Ashwin-Rajesh/PLL_OSU180nm_VSD/docs/charge_pump_ckt.png

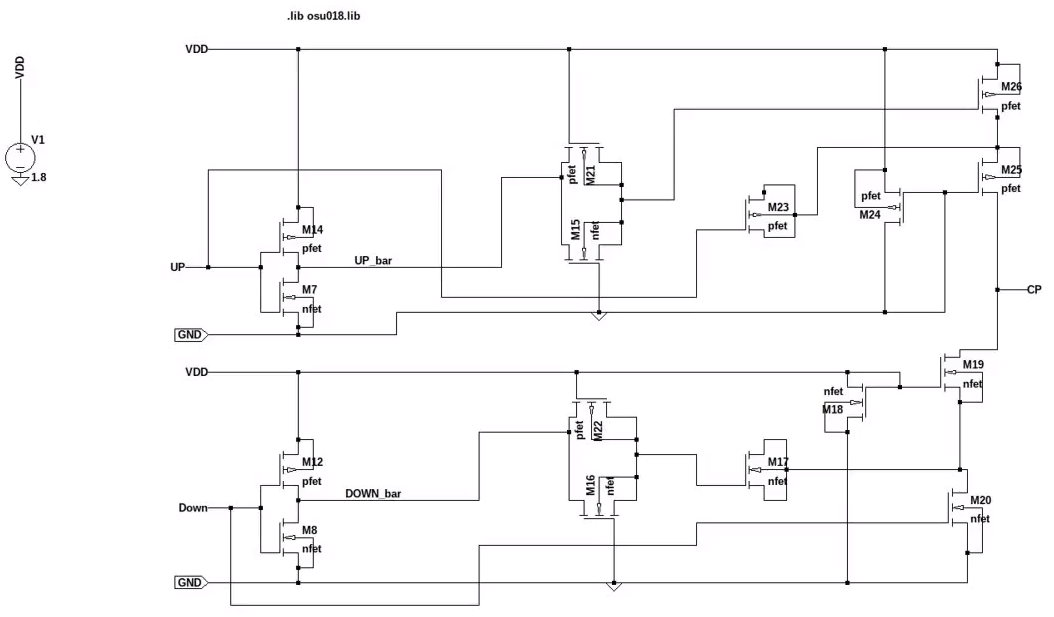
docs/charge_pump_ckt.png
