Ashwin-Rajesh/PLL_OSU180nm_VSD/docs/clk_div_ckt.png

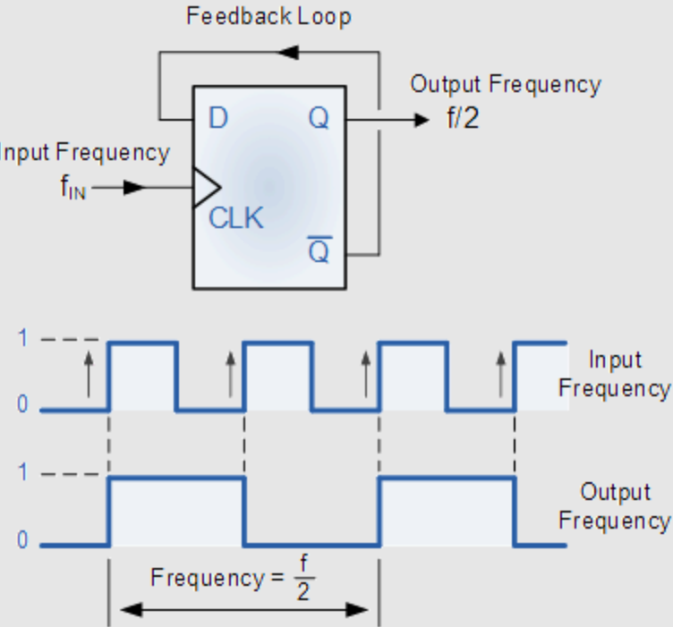
docs/clk_div_ckt.png
