Ashwin-Rajesh/PLL_OSU180nm_VSD/docs/lpf_ckt.png

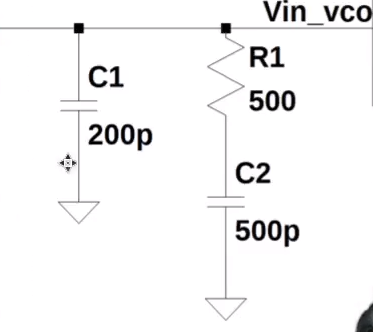
docs/lpf_ckt.png
