Ashwin-Rajesh/PLL_OSU180nm_VSD/docs/post_layout/freqdiv2_layout.png

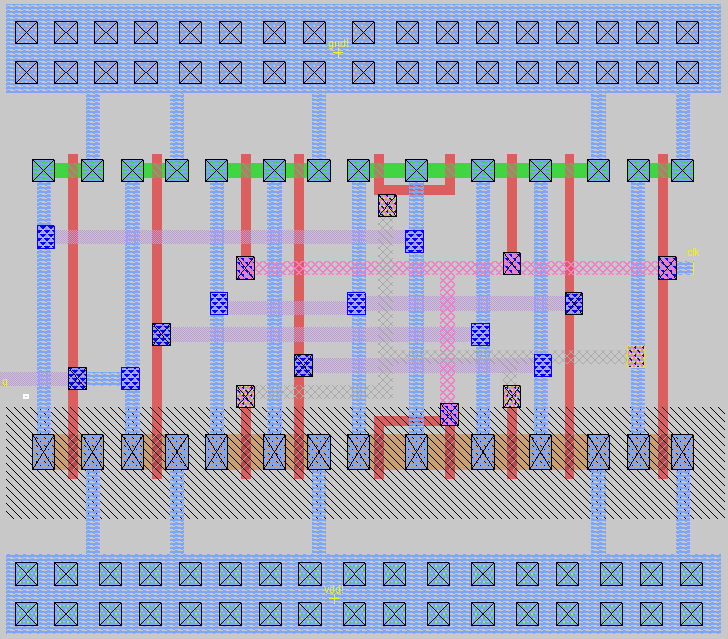
docs/post_layout/freqdiv2_layout.png
