Ashwin-Rajesh/PLL_OSU180nm_VSD/docs/post_layout/freqdiv8_out.png

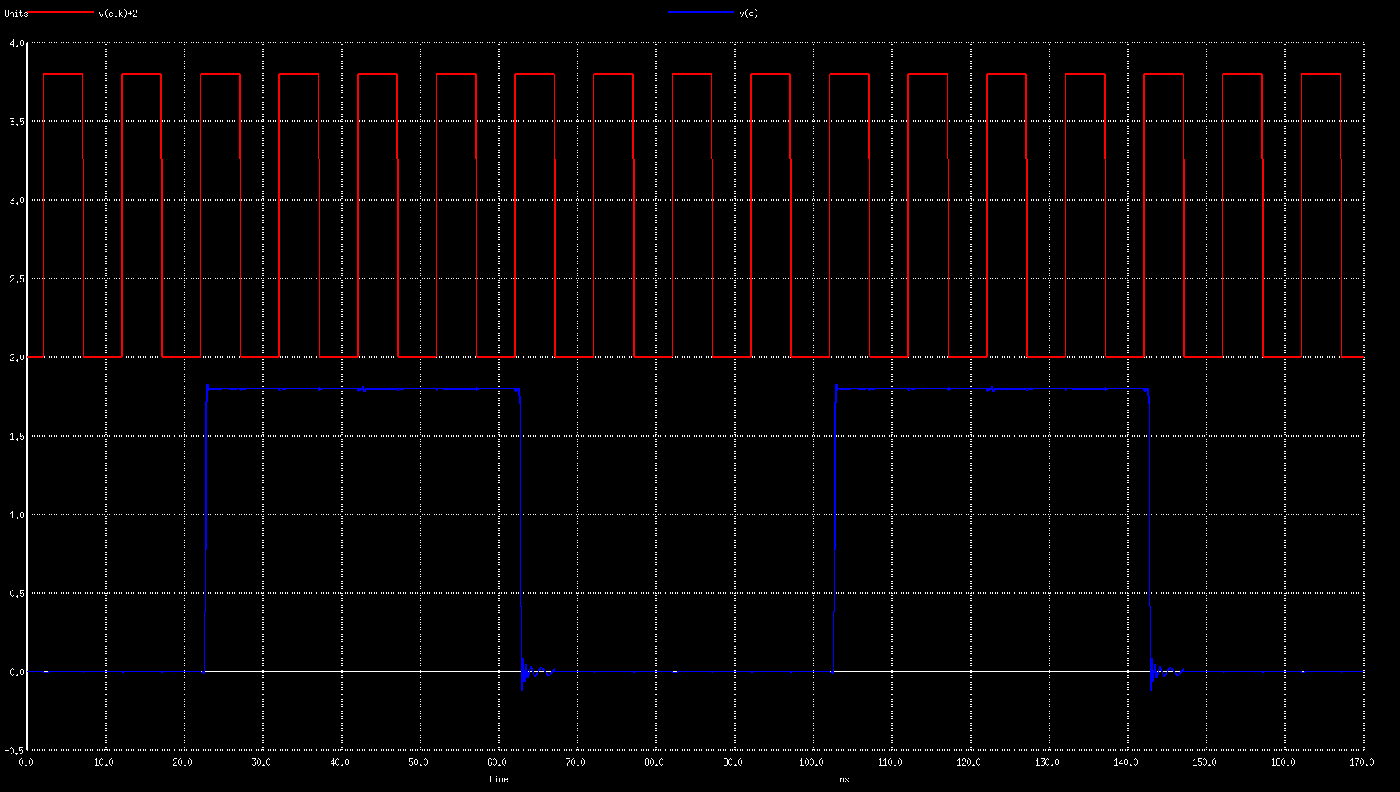
docs/post_layout/freqdiv8_out.png
