Ashwin-Rajesh/PLL_OSU180nm_VSD/docs/post_layout/pfd_layout.png

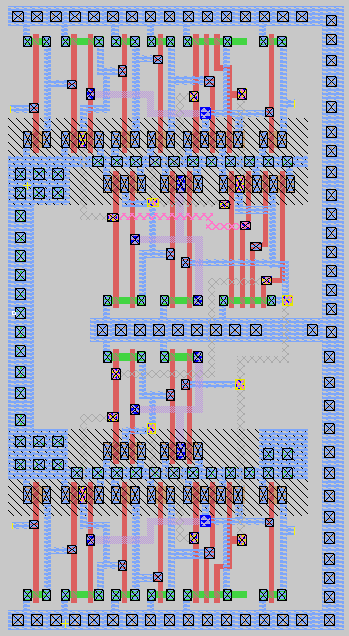
docs/post_layout/pfd_layout.png
