Ashwin-Rajesh/PLL_OSU180nm_VSD/docs/post_layout/pfd_out.png

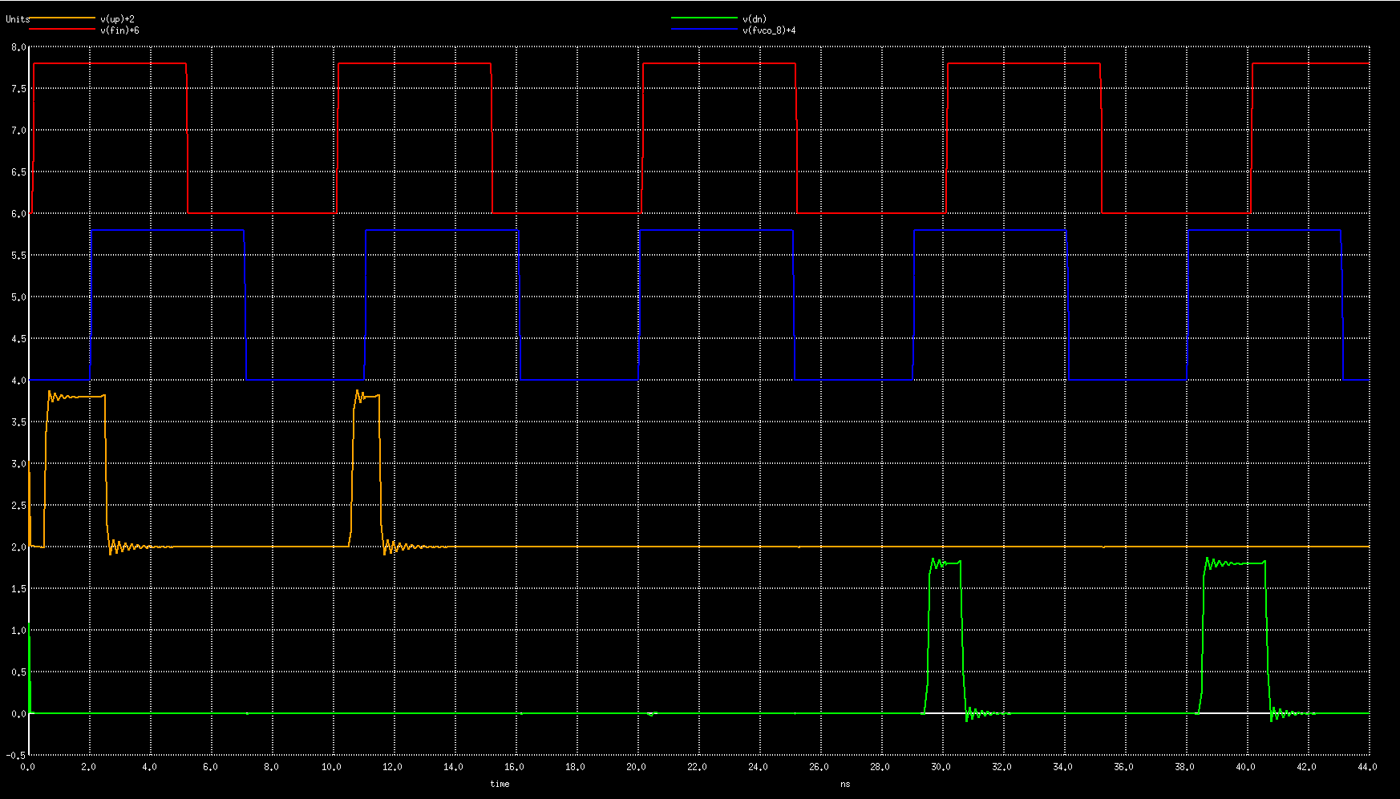
docs/post_layout/pfd_out.png
