Ashwin-Rajesh/PLL_OSU180nm_VSD/docs/post_layout/pll_out_err.png

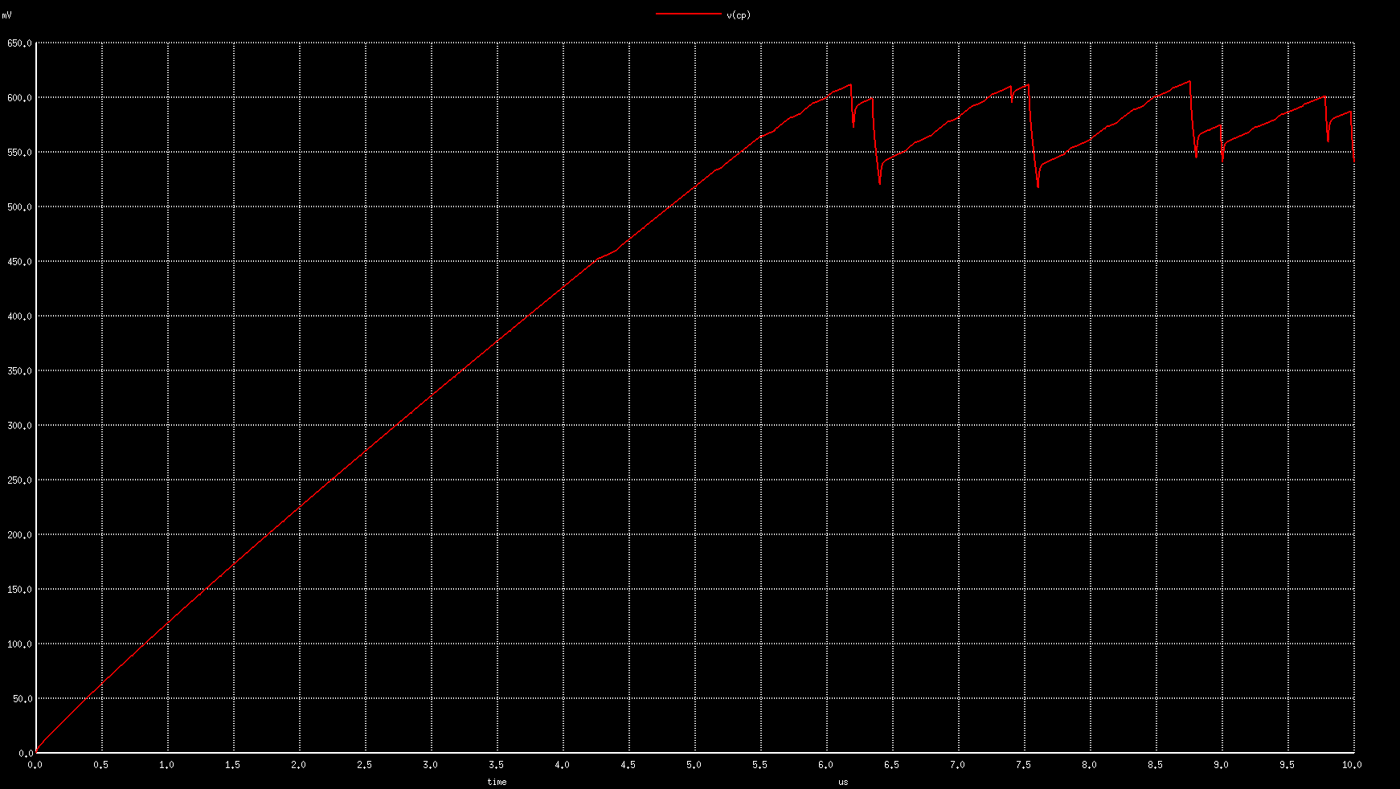
docs/post_layout/pll_out_err.png
