Ashwin-Rajesh/PLL_OSU180nm_VSD/docs/post_layout/vco_out_0.5.png

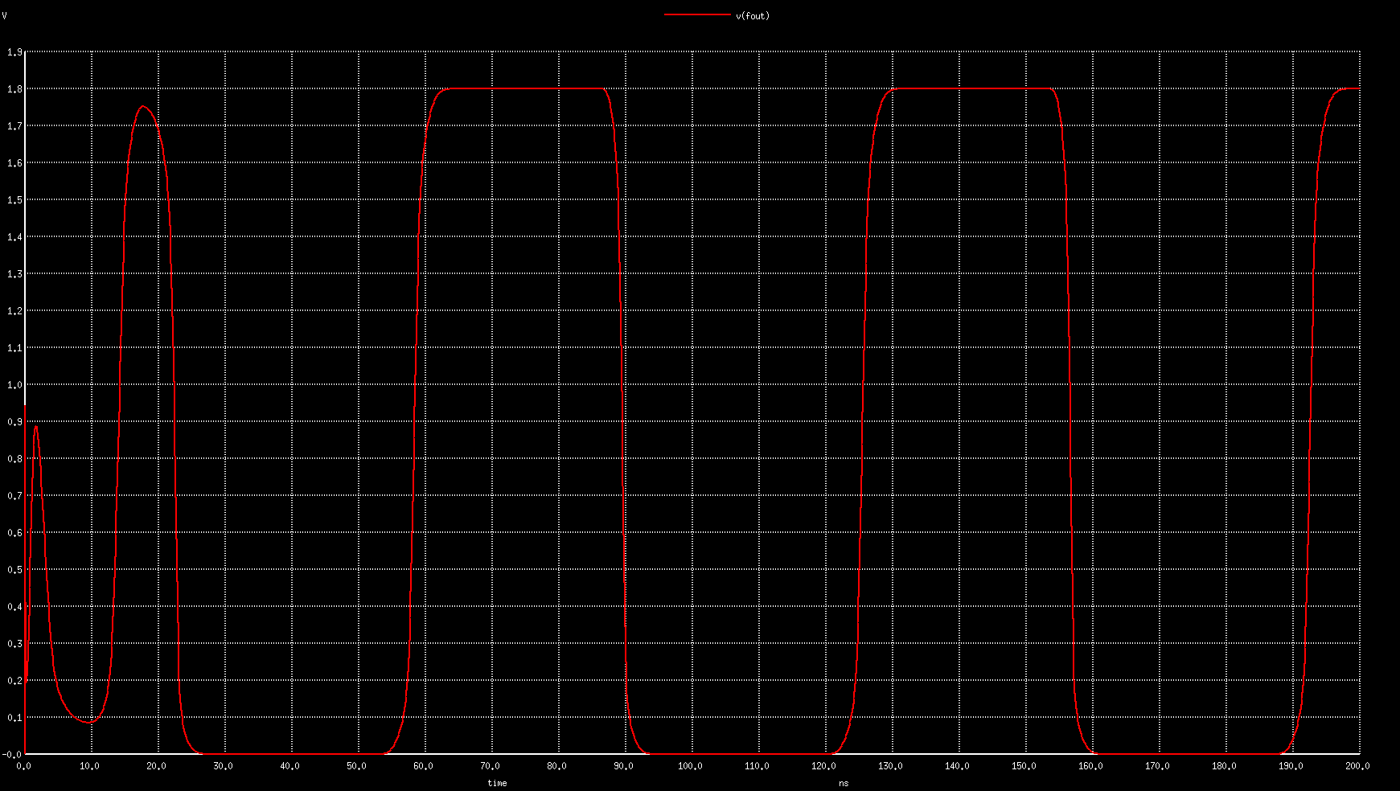
docs/post_layout/vco_out_0.5.png
