Ashwin-Rajesh/PLL_OSU180nm_VSD/docs/pre_layout/clk_div_out.png

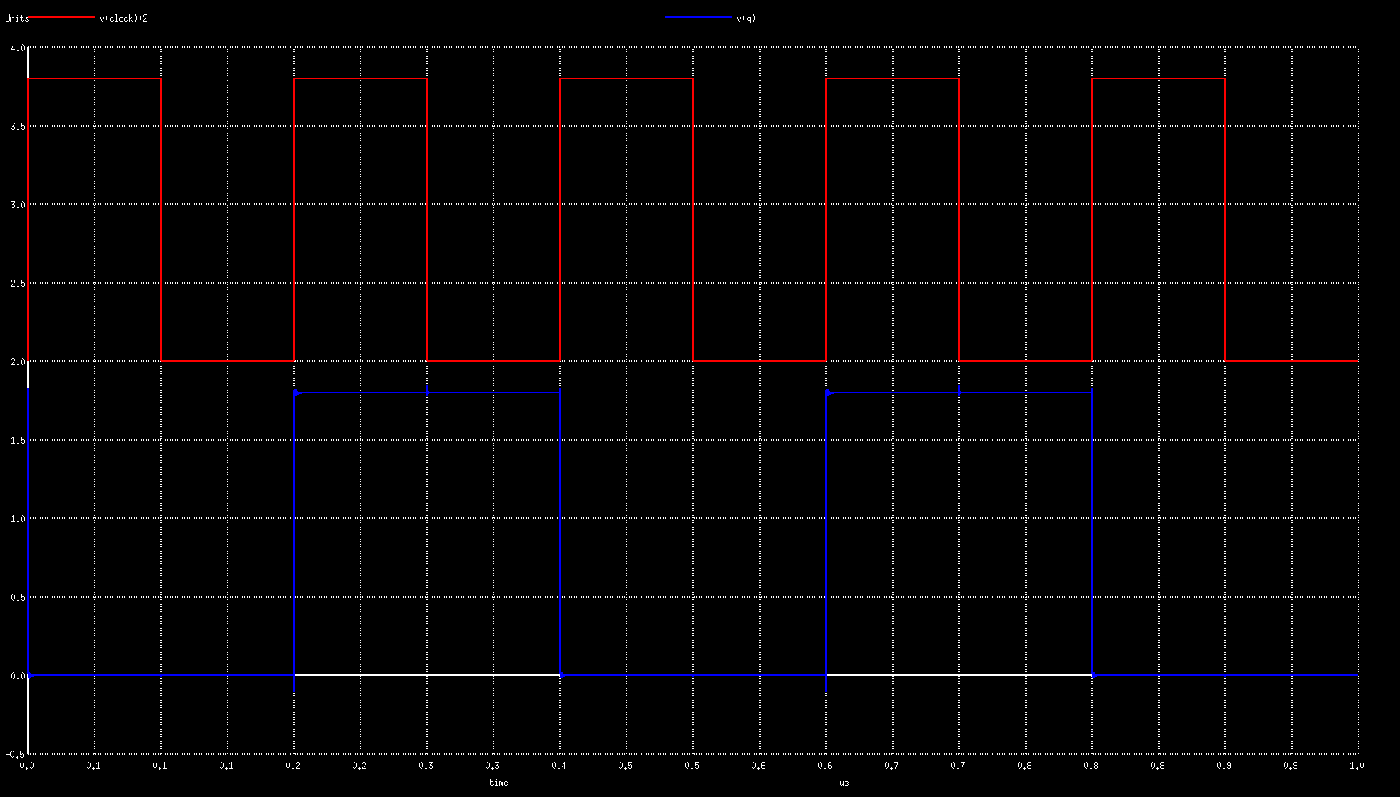
docs/pre_layout/clk_div_out.png
