Ashwin-Rajesh/PLL_OSU180nm_VSD/docs/pre_layout/pll_out.png

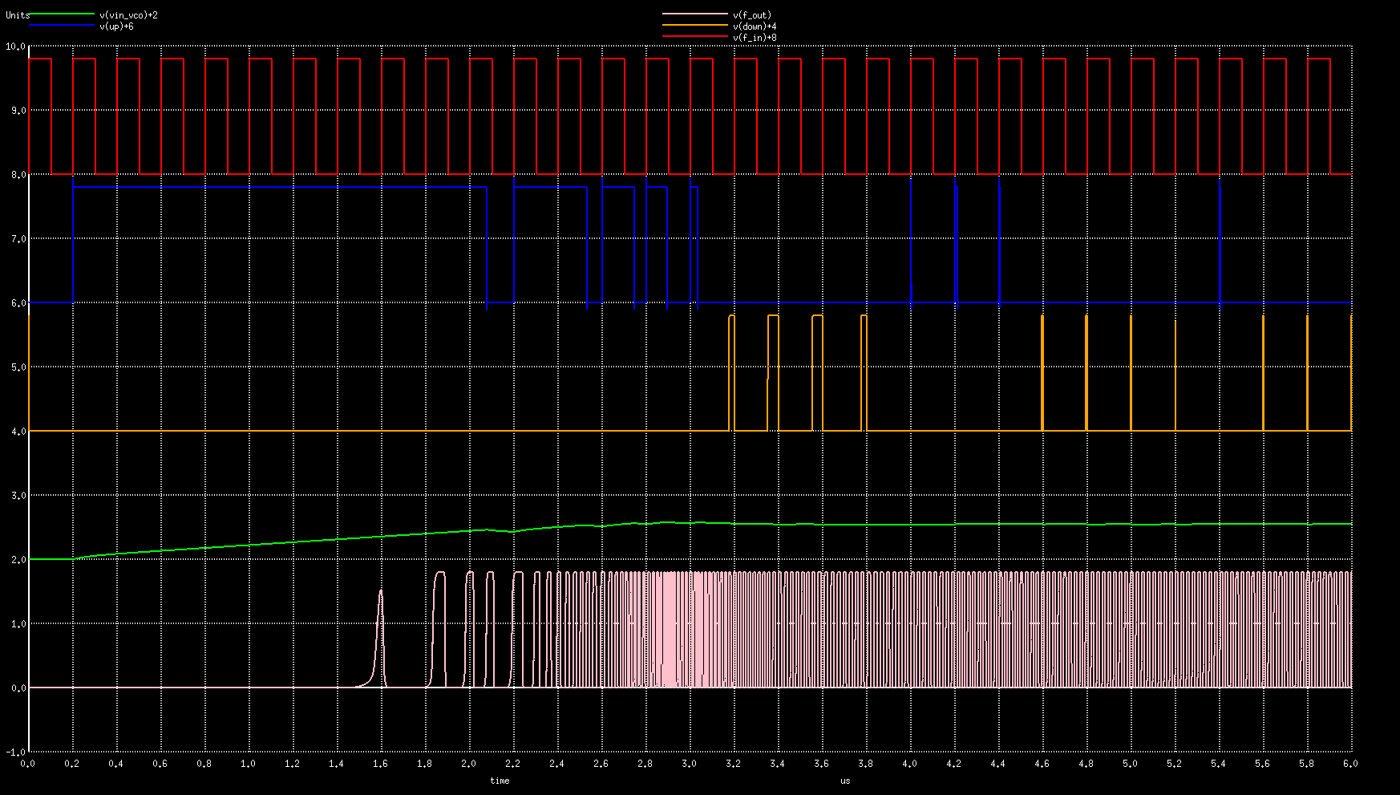
docs/pre_layout/pll_out.png
