Ashwin-Rajesh/PLL_OSU180nm_VSD/docs/pre_layout/vco_out_0.4.png

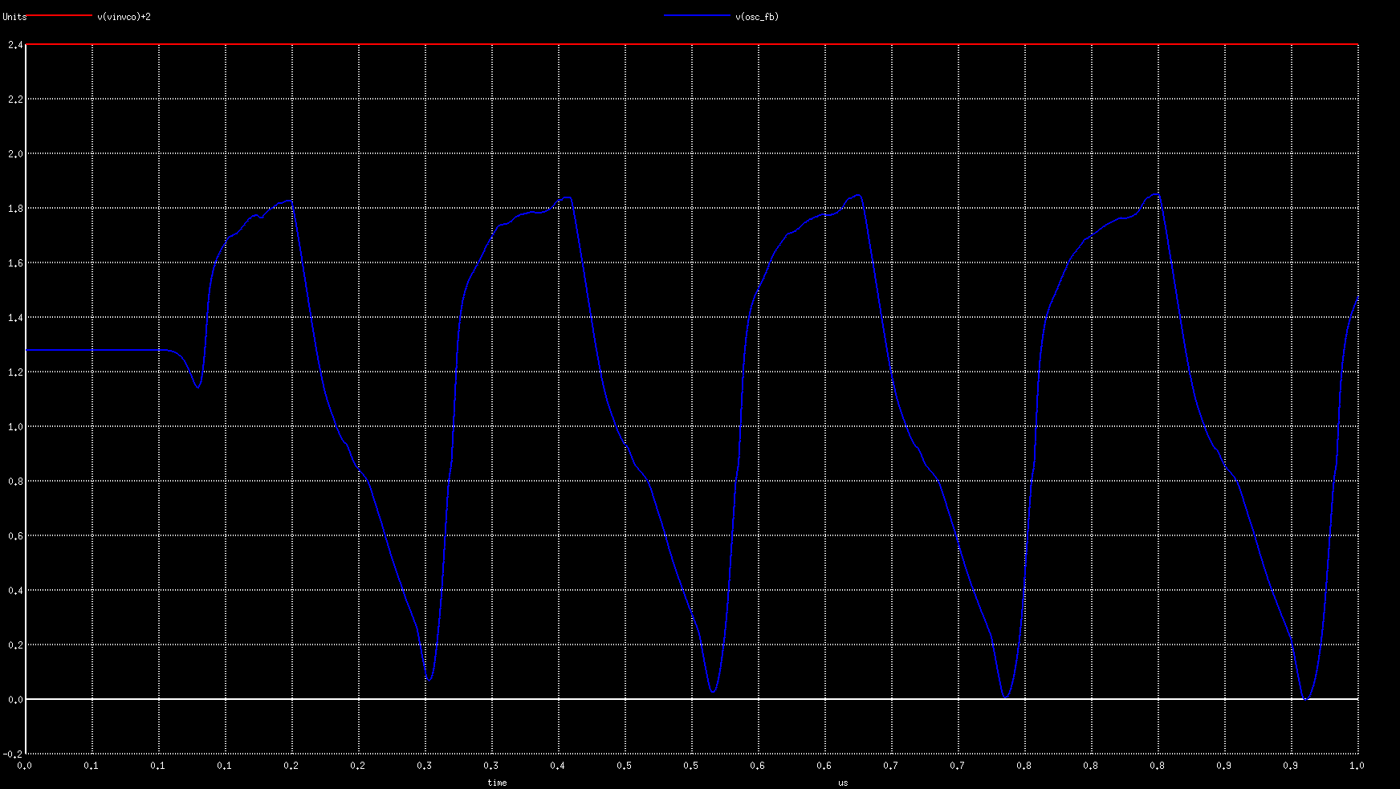
docs/pre_layout/vco_out_0.4.png
