Ashwin-Rajesh/PLL_OSU180nm_VSD/docs/vco_ckt.png

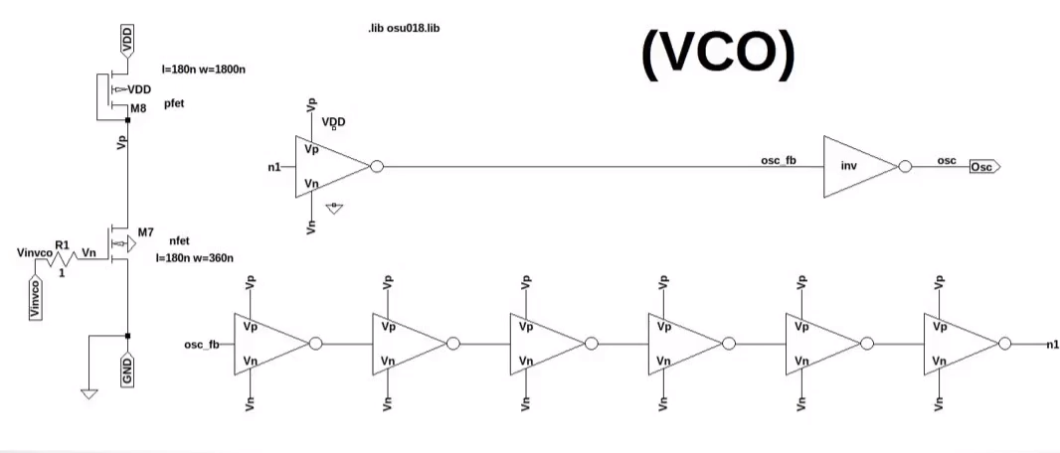
docs/vco_ckt.png
