Ashwin-Rajesh/PLL_OSU180nm_VSD/post_layout/pfd/pfd101v3.sp

*PFD101 without capacitors (fully custom phase freq divider)
* SPICE3 file created from pfd101.ext - technology: scmos

.include osu018.lib


.option scale=0.1u

M1000 up a_42_82# vdd vdd pfet w=11 l=2
+  ad=55 pd=32 as=1804 ps=922
M1001 a_141_n82# a_37_26# a_135_n82# gnd nfet w=13 l=2
+  ad=52 pd=34 as=52 ps=34
M1002 a_68_n189# a_104_n189# a_96_n112# gnd nfet w=6 l=2
+  ad=36 pd=24 as=48 ps=28
M1003 a_96_n291# a_72_n291# vdd vdd pfet w=11 l=2
+  ad=55 pd=32 as=0 ps=0
M1004 a_60_n112# a_37_n224# gnd gnd nfet w=6 l=2
+  ad=48 pd=28 as=586 ps=402
M1005 a_60_n187# a_37_n224# vdd vdd pfet w=11 l=2
+  ad=88 pd=38 as=0 ps=0
M1006 a_37_26# a_12_26# vdd vdd pfet w=11 l=2
+  ad=88 pd=38 as=0 ps=0
M1007 a_96_n291# a_72_n291# gnd gnd nfet w=3 l=2
+  ad=23 pd=20 as=0 ps=0
M1008 a_12_26# fin gnd gnd nfet w=3 l=2
+  ad=23 pd=20 as=0 ps=0
M1009 a_12_n291# fvco_8 vdd vdd pfet w=11 l=2
+  ad=55 pd=32 as=0 ps=0
M1010 a_72_26# a_37_26# vdd vdd pfet w=11 l=2
+  ad=55 pd=32 as=0 ps=0
M1011 a_37_n224# a_12_n291# vdd vdd pfet w=11 l=2
+  ad=88 pd=38 as=0 ps=0
M1012 vdd a_60_n187# a_42_n274# vdd pfet w=11 l=2
+  ad=0 pd=0 as=176 ps=76
M1013 a_12_n291# fvco_8 gnd gnd nfet w=3 l=2
+  ad=23 pd=20 as=0 ps=0
M1014 a_37_26# a_42_82# a_37_100# gnd nfet w=6 l=2
+  ad=36 pd=24 as=48 ps=28
M1015 a_96_n112# a_60_n187# gnd gnd nfet w=6 l=2
+  ad=0 pd=0 as=0 ps=0
M1016 a_68_n189# a_60_n187# vdd vdd pfet w=11 l=2
+  ad=88 pd=38 as=0 ps=0
M1017 a_72_26# a_37_26# gnd gnd nfet w=3 l=2
+  ad=23 pd=20 as=0 ps=0
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
C39 a_68_n189# a_104_n189# 0.06fF
C40 a_72_n291# a_42_n274# 0.03fF
C41 a_42_n274# vdd 0.45fF
C42 a_96_26# a_42_82# 0.04fF
C43 a_104_n189# vdd 0.85fF
C44 a_60_n187# a_37_26# 0.25fF
C45 a_37_n224# a_60_n187# 0.01fF
C46 a_12_n291# vdd 0.25fF
C47 a_42_n274# a_104_n189# 0.10fF
C48 a_72_26# a_42_82# 0.03fF
C49 a_60_n11# vdd 0.51fF
C50 a_68_n83# a_37_26# 0.01fF
C51 a_42_n274# a_12_n291# 0.02fF
C52 fvco_8 vdd 0.07fF
C53 a_37_26# a_42_82# 0.16fF
C54 a_96_26# vdd 0.25fF
C55 a_104_n189# a_60_n11# 0.02fF
C56 m2_154_n253# vdd 0.09fF
C57 a_72_26# vdd 0.25fF
C58 m2_154_n253# gnd 0.03fF **FLOATING
C59 dn gnd 0.28fF
C60 a_96_n291# gnd 0.73fF
C61 a_72_n291# gnd 0.78fF
C62 a_42_n274# gnd 1.59fF
C63 a_12_n291# gnd 0.83fF
C64 fvco_8 gnd 0.51fF
C65 a_68_n189# gnd 0.80fF
C66 a_37_n224# gnd 1.99fF
C67 a_60_n187# gnd 1.82fF
C68 a_68_n83# gnd 0.80fF
C69 up gnd 0.28fF
C70 a_104_n189# gnd 2.65fF
C71 a_60_n11# gnd 1.69fF
C72 a_96_26# gnd 0.73fF
C73 a_72_26# gnd 0.78fF
C74 a_37_26# gnd 1.80fF
C75 fin gnd 0.51fF
C76 a_42_82# gnd 1.59fF
C77 a_12_26# gnd 0.83fF
C78 vdd gnd 15.91fF

v1 vdd gnd 1.8
v2 fin gnd pulse 0 1.8 .1n 60p 60p 5n 10n
v3 fvco_8 gnd pulse 0 1.8 2n 60p 60p 5n 9n

.tran .1n 44n uic
.control
run
plot V(fin)+6 V(fvco_8)+4 V(up)+2 V(dn)

.endc
.end
